Cheezwedge/CanCrusherSim/docs/platen-shapes-standard-subset.md

| Platen | Force to get the can to 25 / 20 / 15 / 12 mm thick (N) | Thinnest under load (mm) | Platen energy (J) | Thickness after release (mm) |
|---|---|---|---|---|
| Flat | 965 / 1,301 / 2,367 / 3,134 | 7.0 | 72 | 7.3 |
| Two side plates, 24 mm gap where the bar went | 949 / 1,298 / 2,544 / — | 13.7 | 70 | 13.7 |
| Two side plates, 40 mm gap where the bar went | — / — / — / — | 25.9 | 61 | 26.1 |
