Cheezwedge/CanCrusherSim/docs/one-stroke-coarse.md

| Design | Strokes | Peak press force to reach 25 / 20 / 15 / 12 mm (N) | Energy (J) | Final thickness (mm) |
|---|---|---|---|---|
| Two presses: Ø20 bar, retract, flat platen | 2 | 1,240 / 1,622 / 2,398 / 3,532 | 80 | 8.1 |
| One stroke: bar 30 mm below slotted platen, spring 300→450 N | 1 | 2,419 / 3,387 / 4,443 / 6,699 | 131 | 11.4 |
| One stroke: bar 45 mm below slotted platen, spring 300→450 N | 1 | 2,614 / 3,117 / 3,391 / — | 108 | 12.9 |
| One stroke: bar 45 mm below, spring 200→300 N | 1 | 2,754 / 3,562 / 5,386 / — | 113 | 13.9 |
