Cheezwedge/CanCrusherSim/docs/platen-shapes-coarse.md

| Platen | Force to get the can to 25 / 20 / 15 / 12 mm thick (N) | Thinnest under load (mm) | Platen energy (J) | Thickness after release (mm) |
|---|---|---|---|---|
| Flat | 1,240 / 1,622 / 2,398 / 3,532 | 7.7 | 73 | 8.1 |
| Curved, bulging down (R 400 mm) | 1,363 / 1,888 / 2,774 / 4,254 | 9.8 | 76 | 10.0 |
| Curved, bulging down (R 250 mm) | 1,528 / 2,419 / 2,996 / 5,923 | 10.6 | 83 | 10.9 |
| Curved, dished up (R 400 mm) | 1,103 / 1,737 / 2,757 / — | 14.0 | 47 | 14.2 |
| Roof / V pointing down (5°) | 1,383 / 2,602 / 3,359 / 5,451 | 10.2 | 83 | 10.5 |
| Valley / V pointing up (5°) | 1,141 / 1,952 / 3,113 / — | 12.0 | 58 | 12.4 |
| Flat, tilted 8° (one end first) | 2,067 / — / — / — | 22.1 | 40 | 22.9 |
| Hinged clamshell (pivot past one end) | 3,797 / 4,691 / 6,694 / 8,021 | 10.9 | 88 | 11.2 |
