Cheezwedge/CanCrusherSim/docs/two-stage-study-coarse-subset.md

| First press | Press 1 peak (N) | Pull-out on retract (N) | Metal on top of tool | Platen force to 20 / 15 / 10 mm (N) | Final height (mm) | Total energy (J) |
|---|---|---|---|---|---|---|
| Ø10 round bar across the middle | 187 | 1 | no | 1,901 / 2,440 / 5,908 | 8.8 | 88 |
| Ø30 round bar across the middle | 276 | 51 (stuck) | no | 1,791 / 2,952 / 5,062 | 8.2 | 81 |
| Ø20 round bar across the middle, stop at 20 mm | 184 | 0 | no | 2,328 / 2,803 / 5,957 | 8.4 | 98 |
