Cheezwedge/CanCrusherSim/docs/two-stage-study-coarse.md

| First press | Press 1 peak (N) | Pull-out on retract (N) | Metal on top of tool | Platen force to 20 / 15 / 10 mm (N) | Final height (mm) | Total energy (J) |
|---|---|---|---|---|---|---|
| Full flat plate (single press, reference) | 8,738 | — | — | 2,856 / 3,229 / 8,578 | 10.4 | 114 |
| 3 mm plate, 50 mm wide, across the middle, no rod | 464 | 1,406 (stuck) | yes | 1,743 / 2,780 / 5,432 | 8.5 | 76 |
| 20 mm plate, 50 mm wide, across the middle, no rod | 1,202 | 418 (stuck) | yes | 1,772 / 2,784 / 5,468 | 8.8 | 84 |
| 40 mm block, 50 mm wide, across the middle | 1,646 | 75 (stuck) | no | 1,017 / 2,210 / 4,931 | 8.5 | 81 |
| 40 mm block, 50 mm wide, across, stop at 20 mm | 775 | 12 | no | 1,100 / 2,277 / 5,072 | 8.5 | 64 |
| 20 mm wide × 30 mm tall blade across the middle | 258 | 6 | yes | 2,283 / 2,596 / 4,771 | 8.3 | 81 |
| Ø20 round bar across the middle | 226 | 4 | no | 1,636 / 2,398 / 4,422 | 8.1 | 80 |
| Ø40 round bar across the middle | 578 | 154 | yes | 1,352 / 2,165 / 4,546 | 8.4 | 64 |
| Ø20 round bar along the can | 3,979 | 140 | yes | 4,195 / 5,857 / 8,083 | 10.1 | 181 |
| 30 mm wide × 20 mm plate along the can | 6,256 | 49 | no | 1,896 / 3,277 / 7,187 | 9.3 | 169 |
| Top-down, can tilted 15°, full plate to 25 mm | 1,617 | 0 | no | 2,188 / 2,711 / 6,377 | 9.3 | 99 |
