Cheezwedge/CanCrusherSim/docs/two-stage-study-standard-subset.md

| First press | Press 1 peak (N) | Pull-out on retract (N) | Metal on top of tool | Platen force to 20 / 15 / 10 mm (N) | Final height (mm) | Total energy (J) |
|---|---|---|---|---|---|---|
| Full flat plate (single press, reference) | 8,495 | — | — | 2,441 / 3,595 / 5,715 | 9.1 | 119 |
| 3 mm plate, 50 mm wide, across the middle, no rod | 372 | 466 | yes | 897 / 1,688 / 4,516 | 6.5 | 65 |
| 40 mm block, 50 mm wide, across, stop at 20 mm | 748 | 7 | no | 796 / 1,747 / 4,280 | 6.5 | 68 |
| 20 mm wide × 30 mm tall blade across the middle | 224 | 2 | no | 1,515 / 2,319 / 4,075 | 7.2 | 78 |
| Ø20 round bar across the middle | 172 | 0 | no | 1,322 / 2,392 / 4,506 | 7.3 | 77 |
| Ø10 round bar across the middle | 150 | 0 | no | 1,245 / 2,697 / 4,509 | 7.6 | 82 |
