Cheezwedge/CanCrusherSim/cad/out/can_crusher_assembly_closed.step

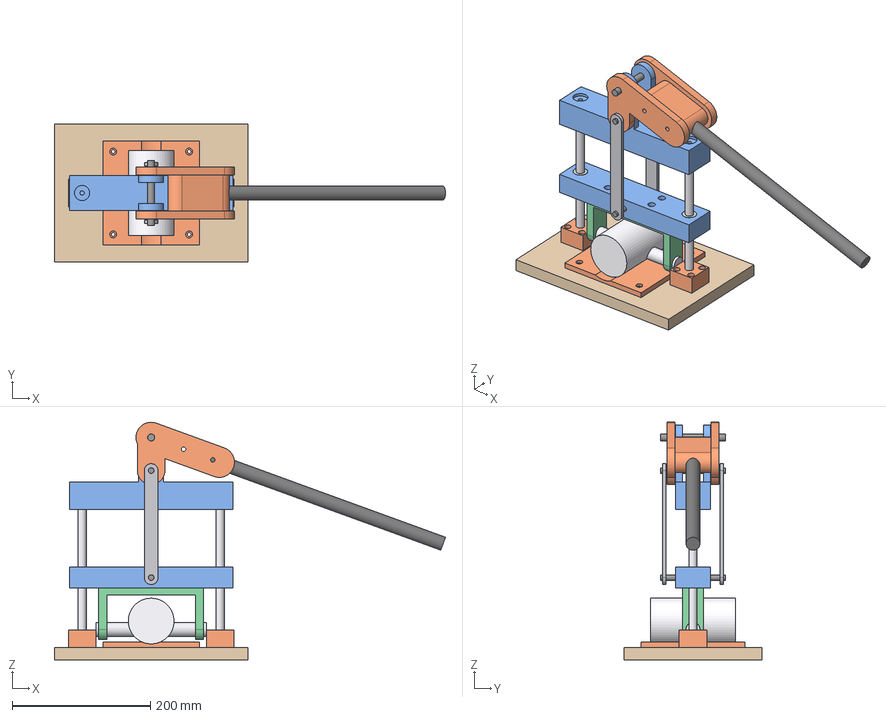
[picture p6: CAD file, 2026-11-07]
cad/out/can_crusher_assembly_closed.step
566.3 x 200.0 x 344.0 mm
base_plate
post_foot_L
post_foot_R
guide_post_L
guide_post_R
cradle
crosshead
bushing_L
bushing_R
bridge
crank_plate_F
crank_plate_B
handle_socket
handle
link_F
link_B
pins
bar_head
crease_bar
can
