Cheezwedge/CanCrusherSim/cad/out_progressive/progressive_crusher_assembly_open.step

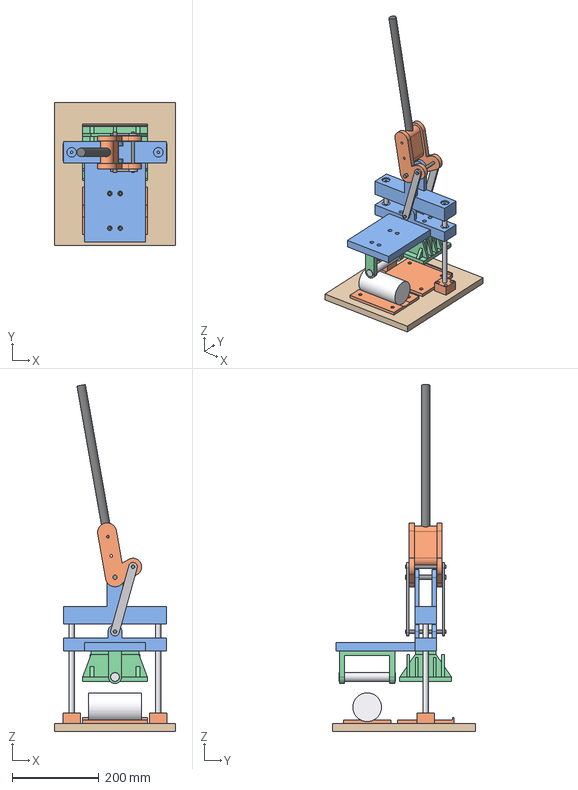
[picture p7: CAD file, 2026-11-07]
cad/out_progressive/progressive_crusher_assembly_open.step
280.0 x 330.0 x 800.9 mm
base_plate
post_foot_L
post_foot_R
guide_post_L
guide_post_R
cradle_station1
pad_station2
crosshead
bushing_L
bushing_R
bridge
crank_plate_F
crank_plate_B
handle_socket
handle
link_F
link_B
pins
bar_head
crease_bar
platen_head
can_station1
