Cheezwedge/CanCrusherSim/cad/out/step/cradle.step

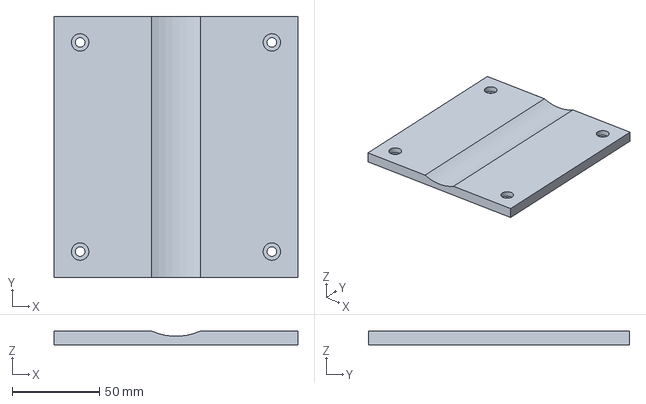
[picture p8: CAD file, 2026-11-07]
cad/out/step/cradle.step
140.0 x 150.0 x 8.00 mm
