Cheezwedge/CanCrusherSim/cad/out_progressive/dxf/link.dxf

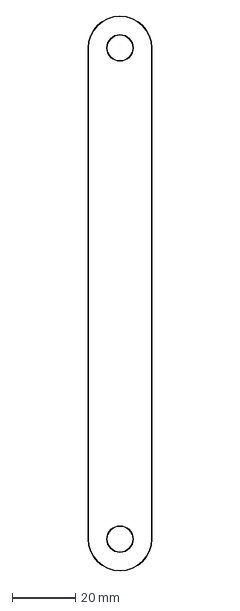
[picture p9: CAD file, 2026-11-07]
cad/out_progressive/dxf/link.dxf
20.0 x 175.0 mm
