Cheezwedge/CanCrusherSim/cad/out_progressive/step/pad_station2.step

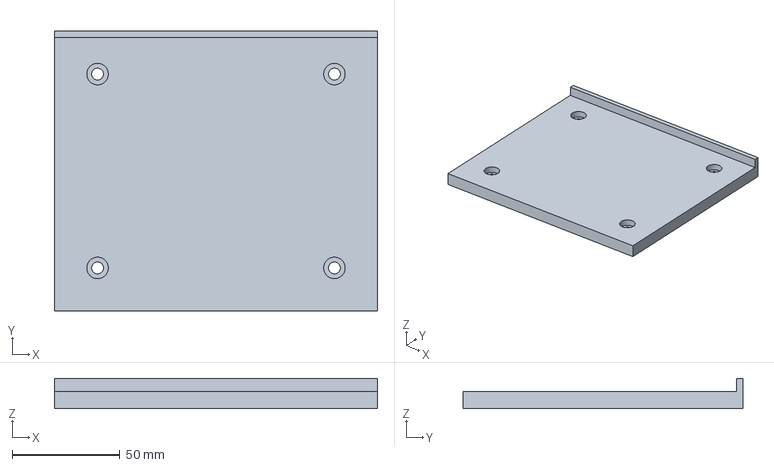
[picture p10: CAD file, 2026-11-07]
cad/out_progressive/step/pad_station2.step
150.0 x 130.0 x 14.0 mm
