Cheezwedge/CanCrusherSim/cad/out_progressive/stl/crank_plate.stl

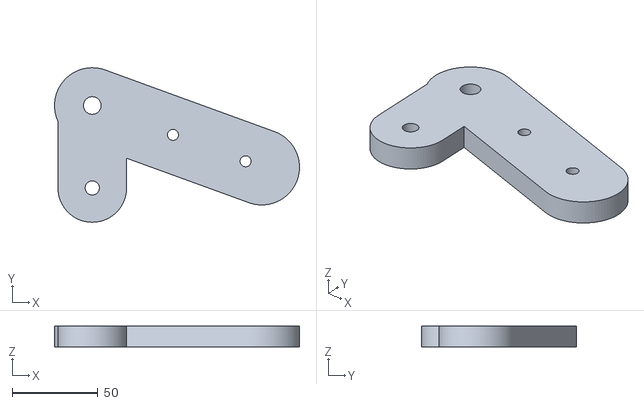
[picture p11: CAD file, 2026-11-07]
cad/out_progressive/stl/crank_plate.stl
142.7 x 90.0 x 12.0
