Cheezwedge/CanCrusherSim/cad/out_rotary/rotary_crusher_crease.step

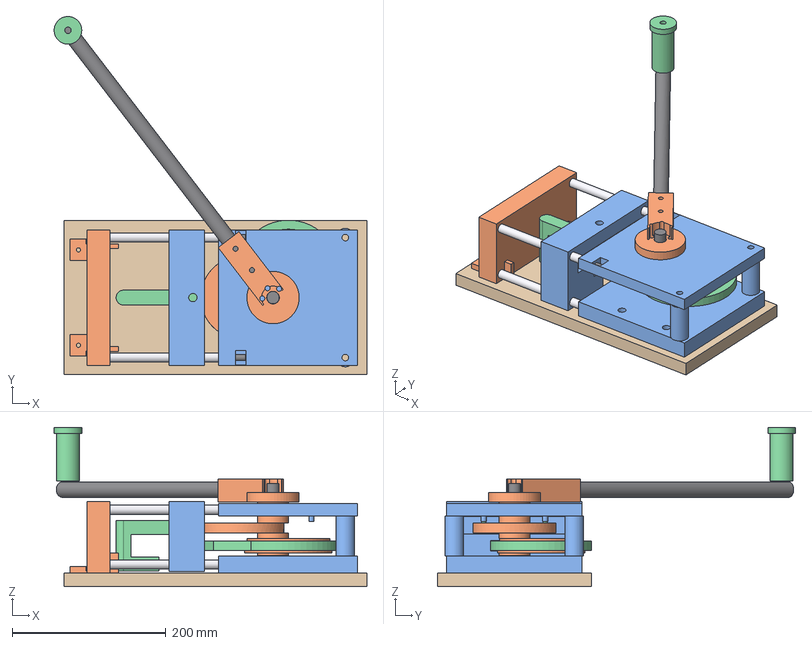
[picture p12: CAD file, 2026-11-11]
cad/out_rotary/rotary_crusher_crease.step
406.6 x 465.5 x 207.2 mm
board
fixed_jaw
platen
wrist_pin
blade
conrod
rotor_lower
rotor_upper
bottom_plate
top_plate
back_post_L
back_post_R
guide_tubes
tie_rods
axle
handle_hub
handle
knob
