Cheezwedge/CanCrusherSim/cad/out_rotary/step/platen.step

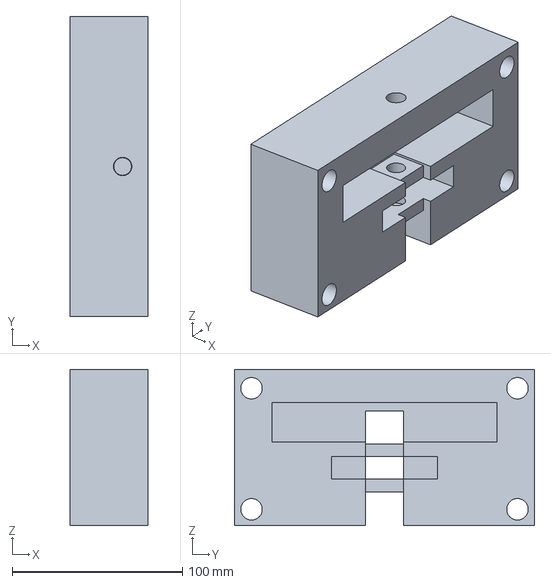
[picture p13: CAD file, 2026-11-11]
cad/out_rotary/step/platen.step
46.0 x 176.0 x 91.5 mm
