Cheezwedge/CanCrusherSim/cad/out_rotary/stl/back_post.stl

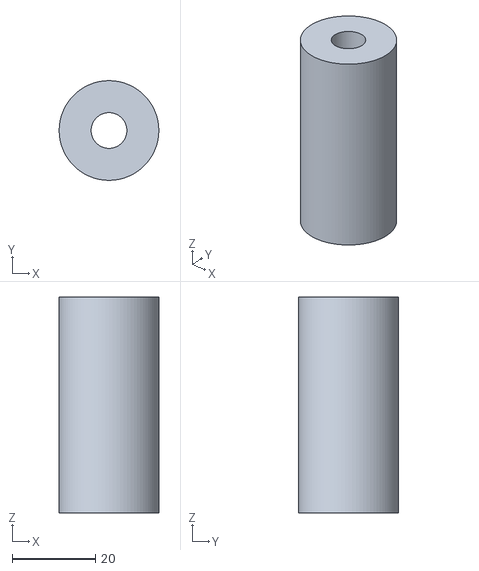
[picture p14: CAD file, 2026-11-11]
cad/out_rotary/stl/back_post.stl
24.0 x 24.0 x 52.0
