Cheezwedge/CanCrusherSim/cad/out_progressive/step/post_foot_R.step

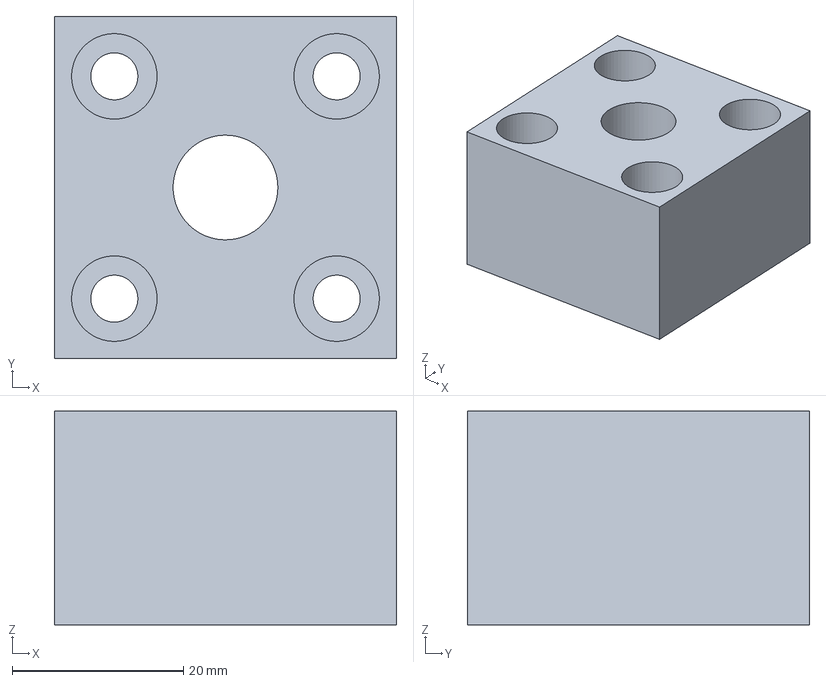
[picture p15: CAD file, 2026-11-07]
cad/out_progressive/step/post_foot_R.step
40.0 x 40.0 x 25.0 mm
