Cheezwedge/CanCrusherSim/cad/out_rotary/rotary_crusher_load.step

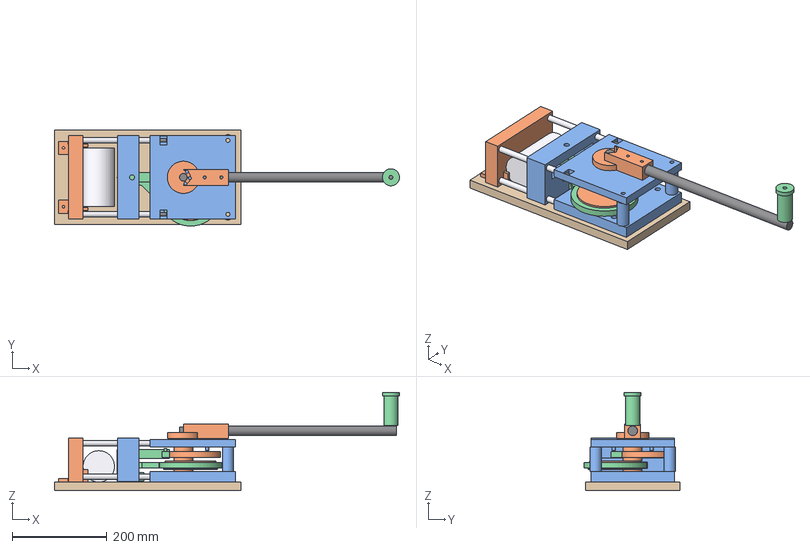
[picture p16: CAD file, 2026-11-11]
cad/out_rotary/rotary_crusher_load.step
728.0 x 202.9 x 207.2 mm
board
fixed_jaw
platen
wrist_pin
blade
conrod
rotor_lower
rotor_upper
bottom_plate
top_plate
back_post_L
back_post_R
guide_tubes
tie_rods
axle
handle_hub
handle
knob
can
