Cheezwedge/CanCrusherSim/cad/out_rotary/step/tie_rods.step

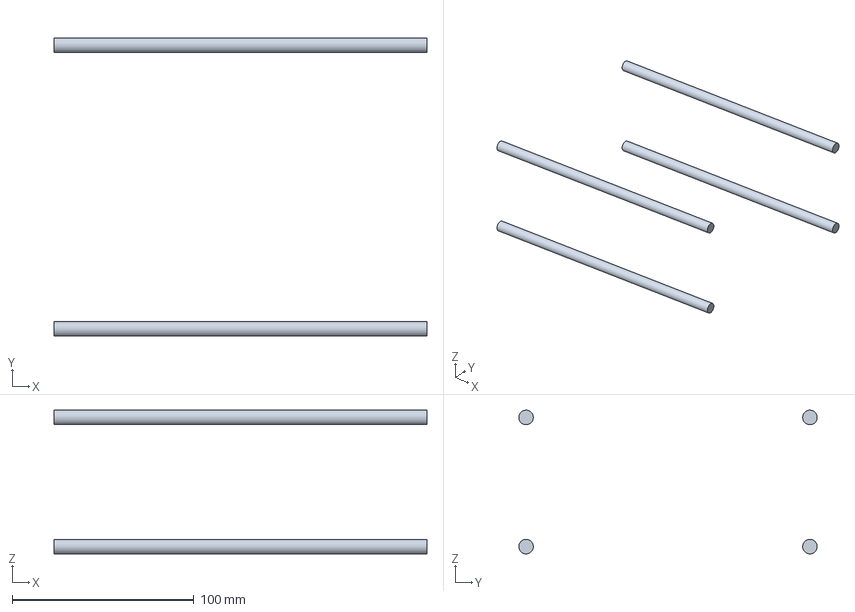
[picture p17: CAD file, 2026-11-11]
cad/out_rotary/step/tie_rods.step
205.0 x 164.0 x 79.0 mm
