Cheezwedge/CanCrusherSim/cad/out_progressive/step/guide_post_R.step

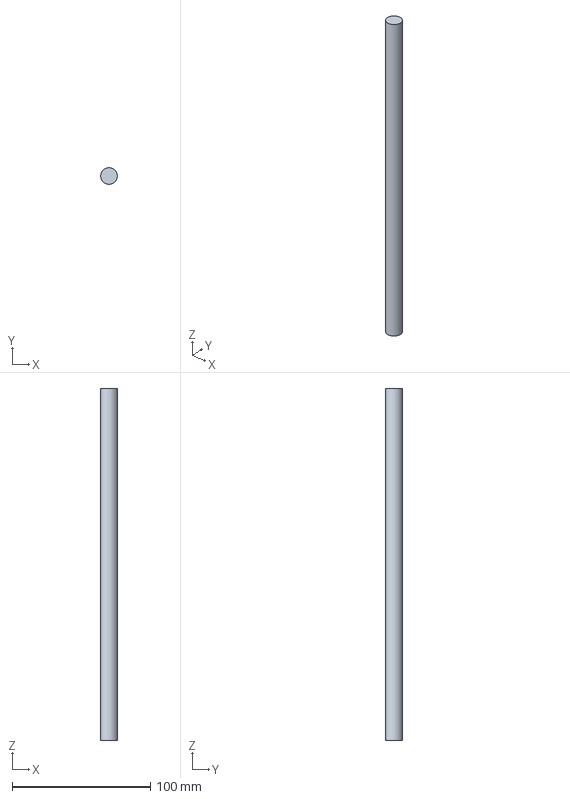
[picture p18: CAD file, 2026-11-07]
cad/out_progressive/step/guide_post_R.step
12.0 x 12.0 x 254.2 mm
