Cheezwedge/CanCrusherSim/cad/out_rotary/rotary_crusher_pressed.step

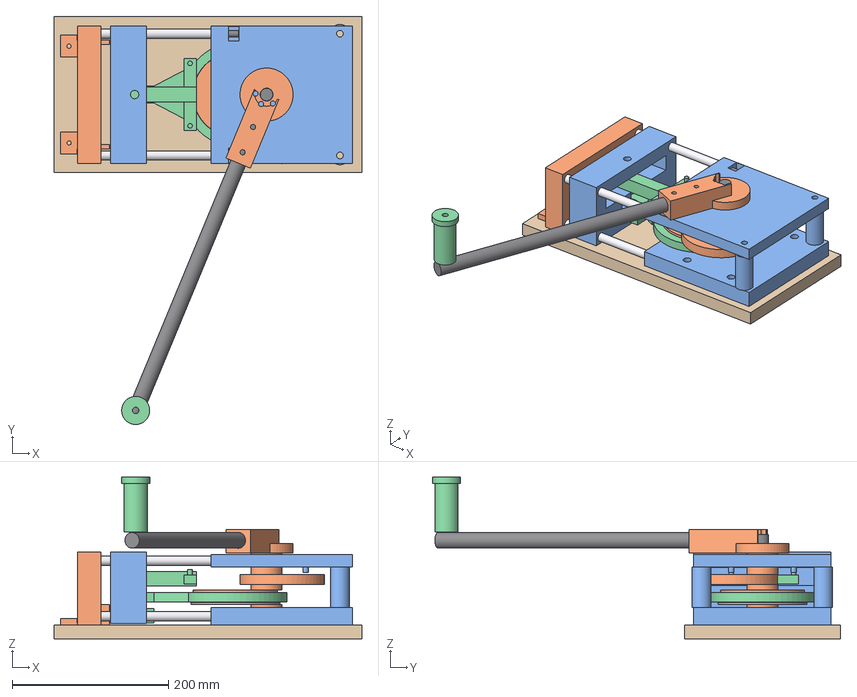
[picture p19: CAD file, 2026-11-11]
cad/out_rotary/rotary_crusher_pressed.step
394.0 x 522.7 x 207.2 mm
board
fixed_jaw
platen
wrist_pin
blade
conrod
rotor_lower
rotor_upper
bottom_plate
top_plate
back_post_L
back_post_R
guide_tubes
tie_rods
axle
handle_hub
handle
knob
