Cheezwedge/CanCrusherSim/cad/out_rotary/step/handle_hub.step

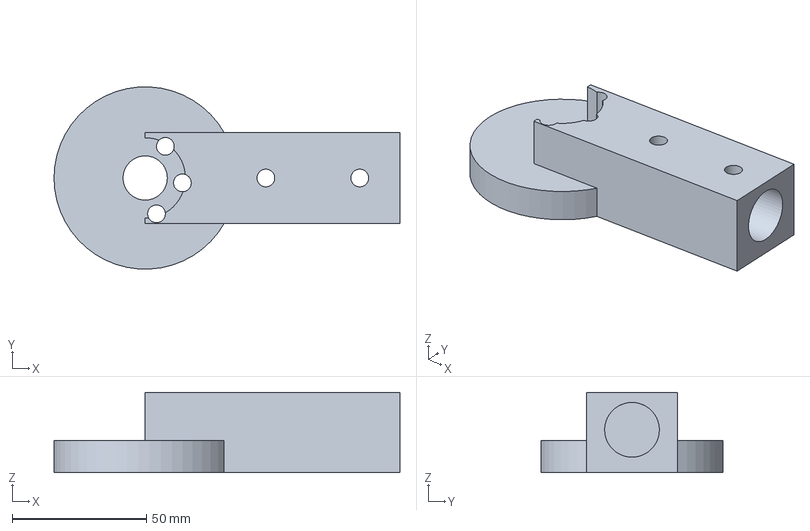
[picture p20: CAD file, 2026-11-11]
cad/out_rotary/step/handle_hub.step
129.0 x 67.9 x 30.0 mm
