Cheezwedge/CanCrusherSim/cad/out_progressive/step/bushing_R.step

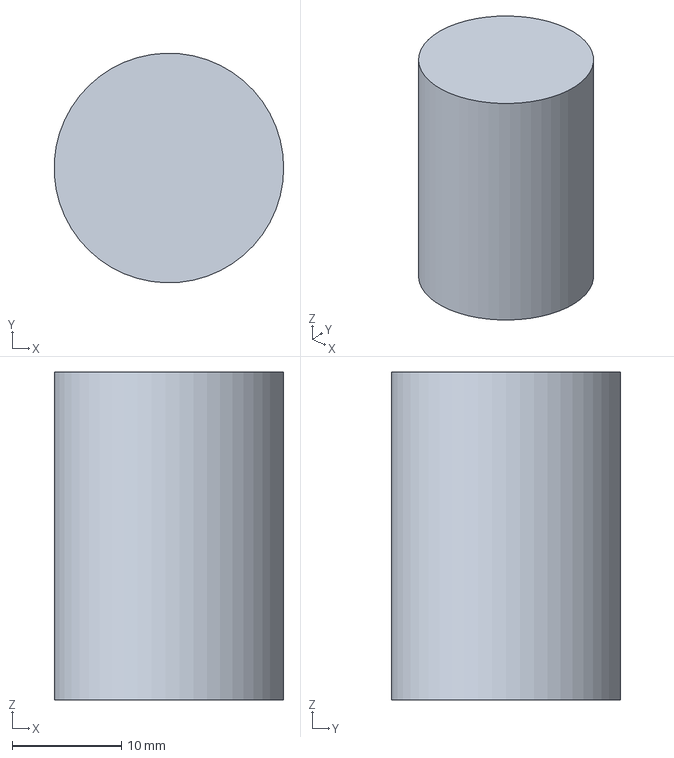
[picture p21: CAD file, 2026-11-07]
cad/out_progressive/step/bushing_R.step
21.0 x 21.0 x 30.0 mm
