Cheezwedge/CanCrusherSim/cad/out_rotary/step/handle.step

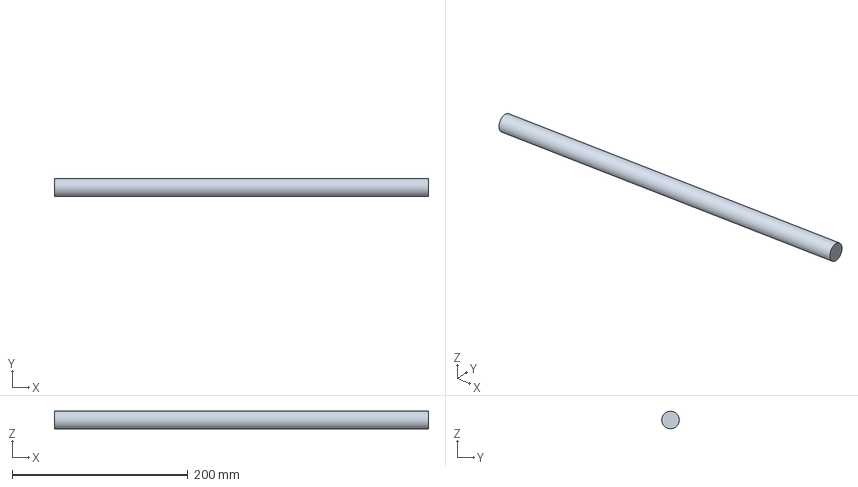
[picture p22: CAD file, 2026-11-11]
cad/out_rotary/step/handle.step
426.0 x 20.0 x 20.0 mm
