Cheezwedge/CanCrusherSim/cad/out_progressive/step/bar_head.step

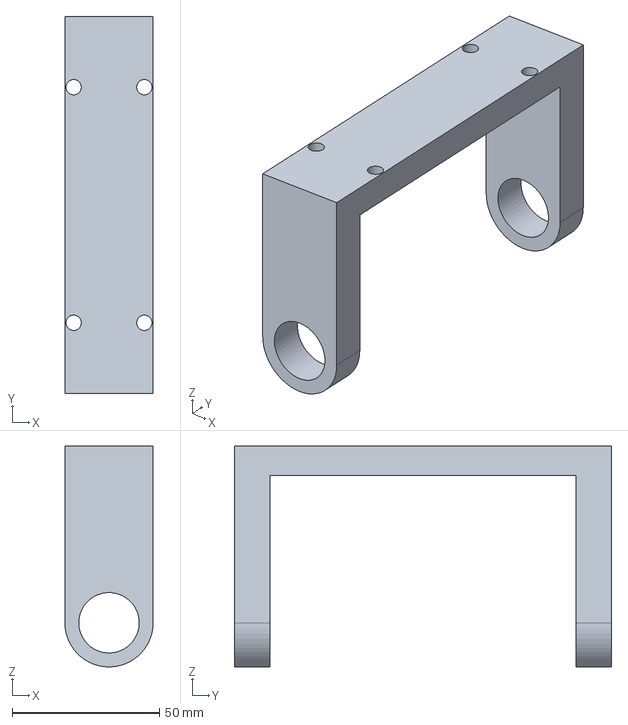
[picture p23: CAD file, 2026-11-07]
cad/out_progressive/step/bar_head.step
30.0 x 128.0 x 75.0 mm
