Cheezwedge/CanCrusherSim/cad/out_rotary/step/fixed_jaw.step

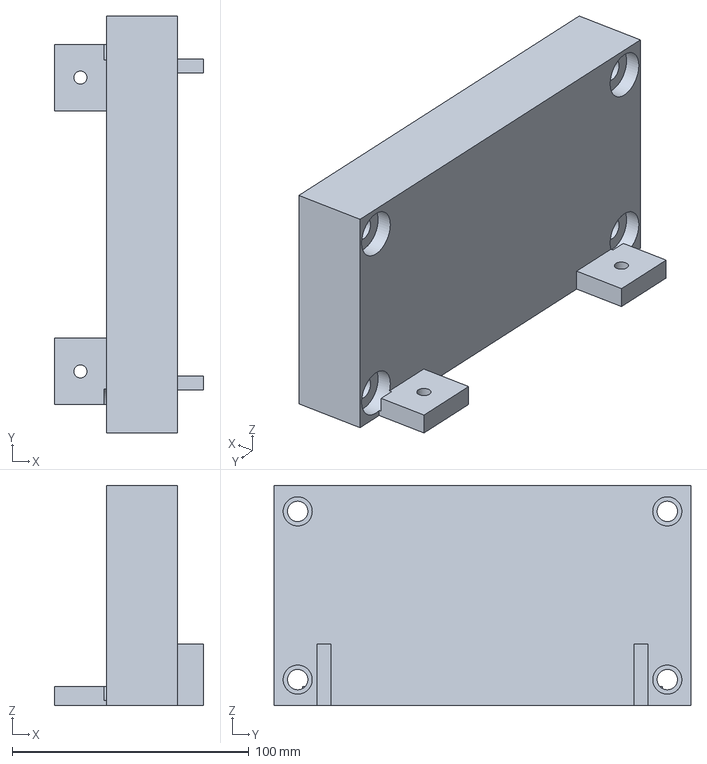
[picture p24: CAD file, 2026-11-11]
cad/out_rotary/step/fixed_jaw.step
63.0 x 176.0 x 93.0 mm
