Cheezwedge/CanCrusherSim/cad/out_rotary/step/bottom_plate.step

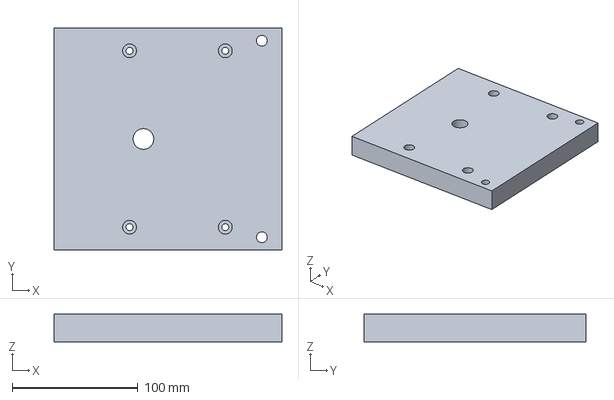
[picture p25: CAD file, 2026-11-11]
cad/out_rotary/step/bottom_plate.step
181.0 x 176.0 x 22.0 mm
