Cheezwedge/CanCrusherSim/cad/out_progressive/step/can_station1.step

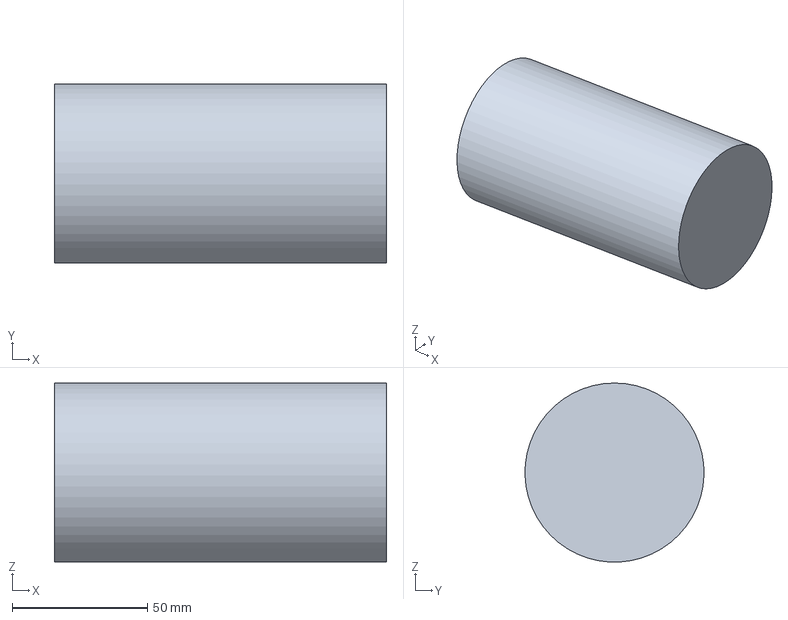
[picture p26: CAD file, 2026-11-07]
cad/out_progressive/step/can_station1.step
122.7 x 66.2 x 66.1 mm
