Cheezwedge/CanCrusherSim/cad/out_rotary/step/wrist_pin.step

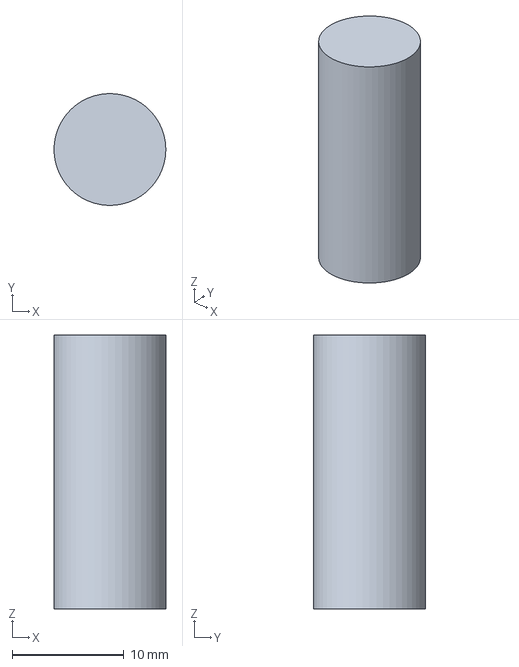
[picture p27: CAD file, 2026-11-11]
cad/out_rotary/step/wrist_pin.step
9.99 x 10.00 x 24.5 mm
