Cheezwedge/CanCrusherSim/cad/out_progressive/step/cradle_station1.step

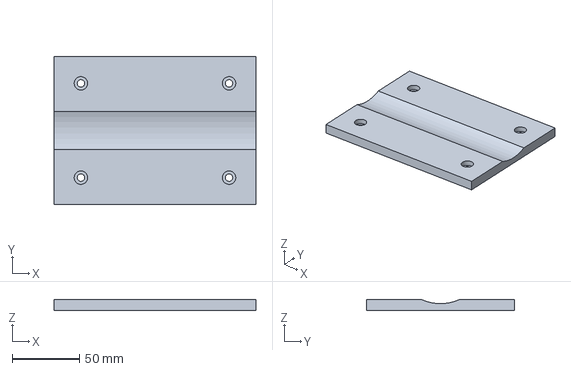
[picture p28: CAD file, 2026-11-07]
cad/out_progressive/step/cradle_station1.step
150.0 x 110.0 x 8.00 mm
