Cheezwedge/CanCrusherSim/cad/out_rotary/step/axle.step

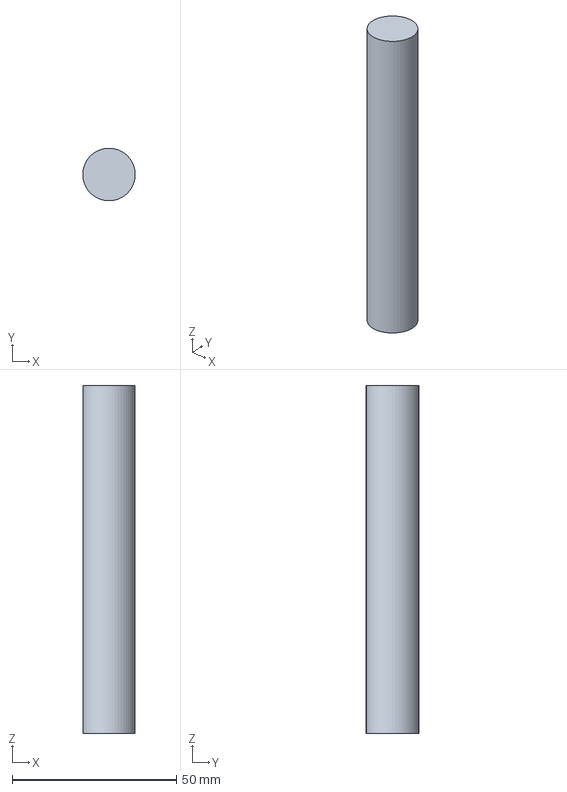
[picture p29: CAD file, 2026-11-11]
cad/out_rotary/step/axle.step
16.0 x 16.0 x 106.0 mm
