Cheezwedge/CanCrusherSim/cad/out_rotary/step/rotor_upper.step

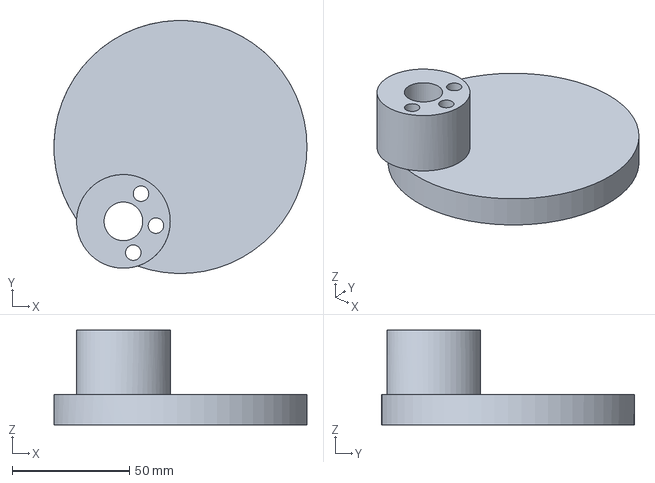
[picture p30: CAD file, 2026-11-11]
cad/out_rotary/step/rotor_upper.step
108.0 x 108.0 x 40.5 mm
