Cheezwedge/CanCrusherSim/cad/out_progressive/step/crosshead.step

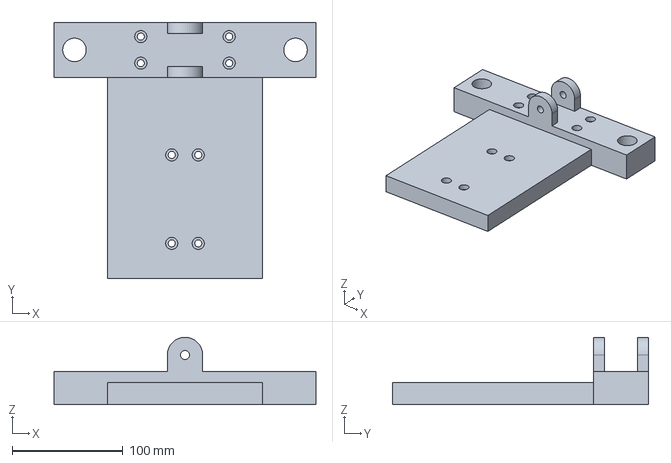
[picture p31: CAD file, 2026-11-07]
cad/out_progressive/step/crosshead.step
237.0 x 232.0 x 61.0 mm
