Cheezwedge/CanCrusherSim/cad/out_rotary/step/blade.step

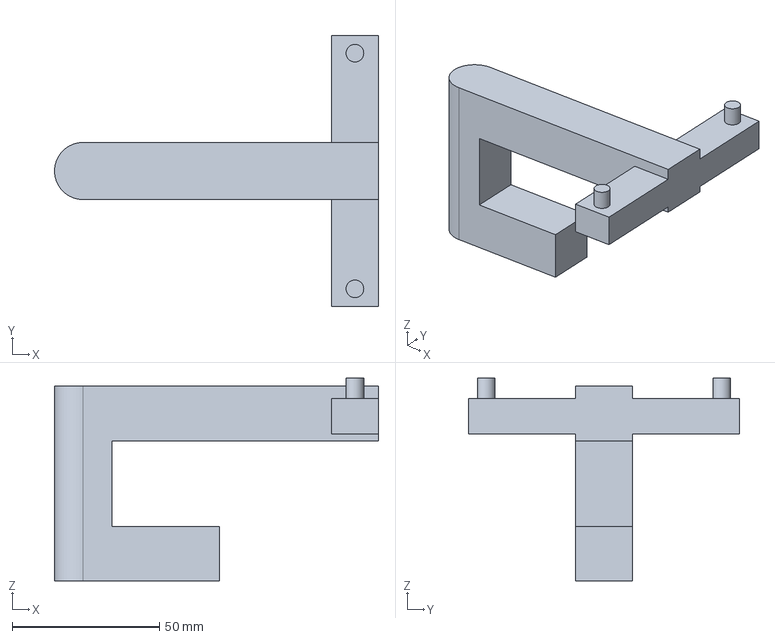
[picture p32: CAD file, 2026-11-11]
cad/out_rotary/step/blade.step
110.0 x 92.0 x 68.9 mm
