Cheezwedge/CanCrusherSim/cad/out_progressive/step/bridge.step

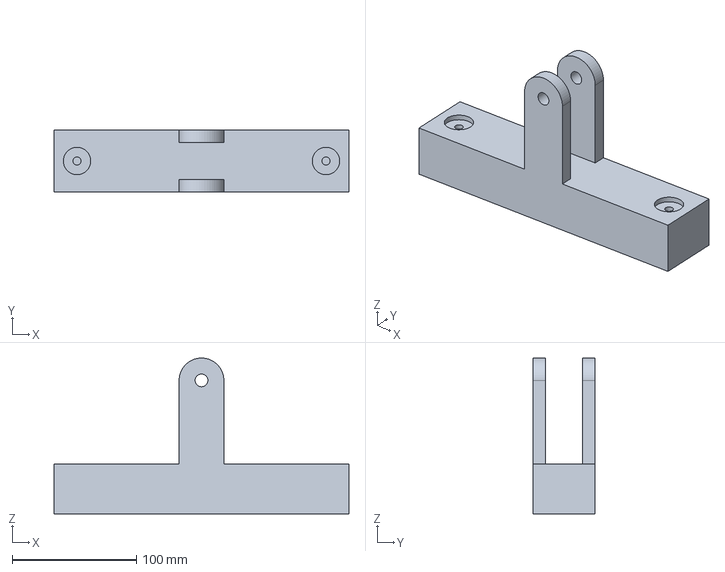
[picture p33: CAD file, 2026-11-07]
cad/out_progressive/step/bridge.step
237.0 x 50.0 x 125.3 mm
