Cheezwedge/CanCrusherSim/cad/out_rotary/step/guide_tubes.step

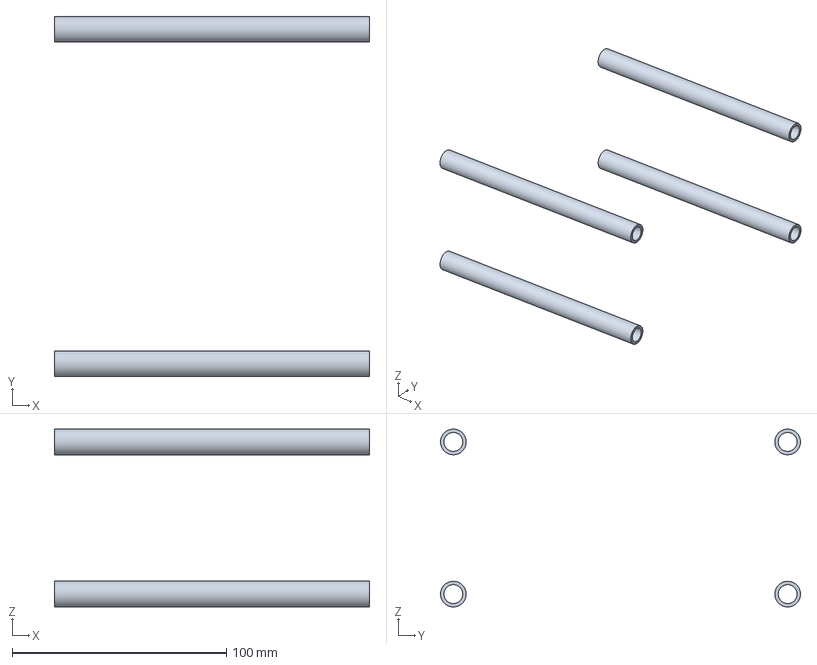
[picture p34: CAD file, 2026-11-11]
cad/out_rotary/step/guide_tubes.step
147.0 x 168.0 x 83.0 mm
