Cheezwedge/CanCrusherSim/cad/out_progressive/step/handle.step

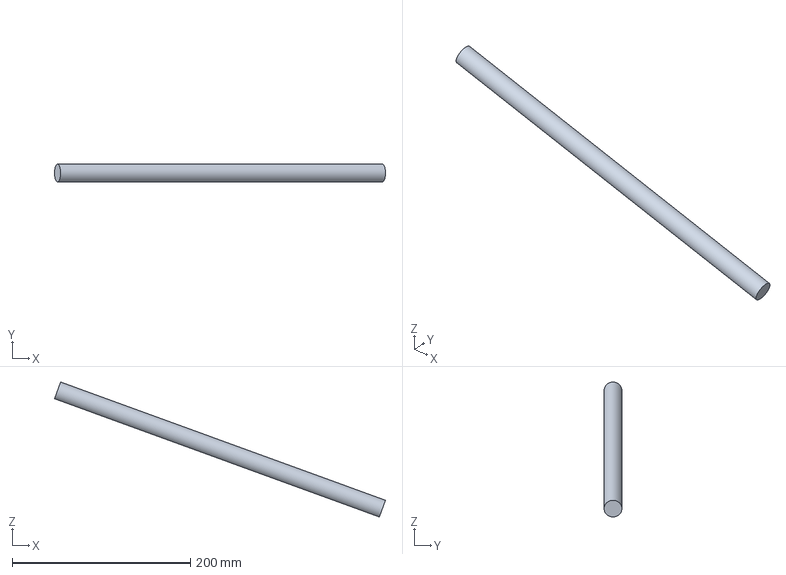
[picture p35: CAD file, 2026-11-07]
cad/out_progressive/step/handle.step
371.4 x 20.0 x 151.5 mm
