Cheezwedge/CanCrusherSim/cad/out_rotary/step/top_plate.step

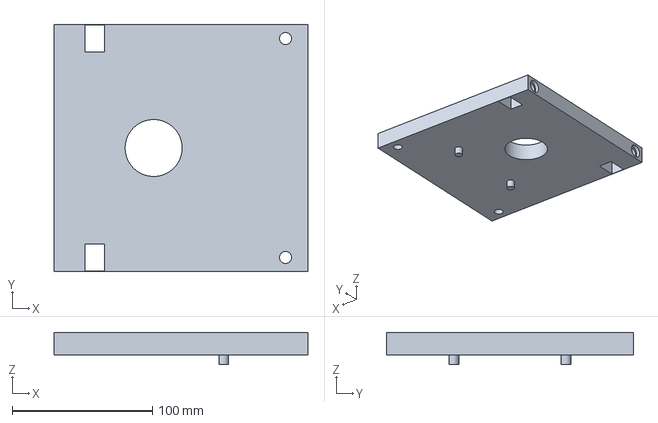
[picture p36: CAD file, 2026-11-11]
cad/out_rotary/step/top_plate.step
181.0 x 176.0 x 23.0 mm
