Cheezwedge/CanCrusherSim/cad/out_progressive/step/base_plate.step

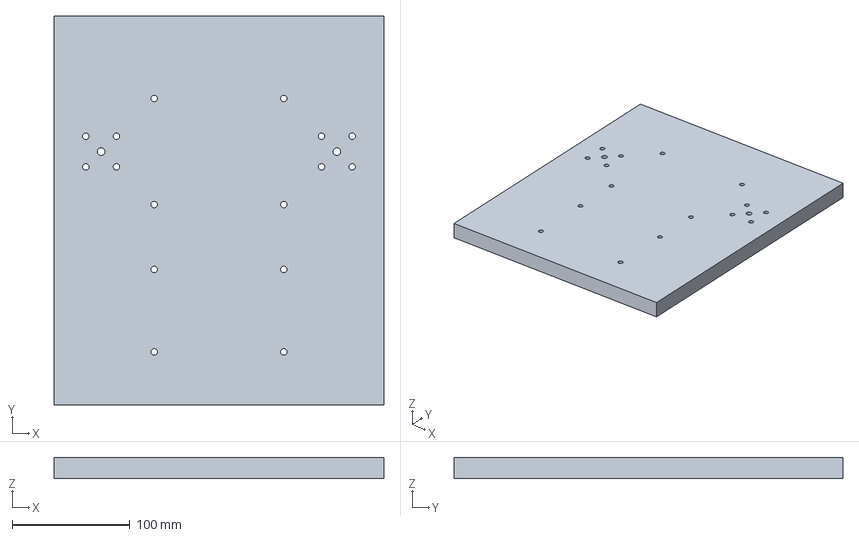
[picture p37: CAD file, 2026-11-07]
cad/out_progressive/step/base_plate.step
280.0 x 330.0 x 18.0 mm
