Cheezwedge/CanCrusherSim/cad/out_rotary/step/rotor_lower.step

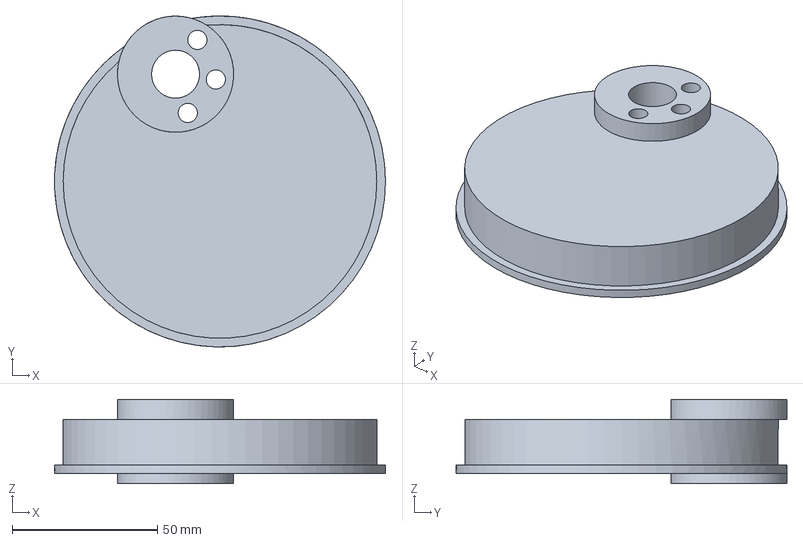
[picture p38: CAD file, 2026-11-11]
cad/out_rotary/step/rotor_lower.step
114.0 x 114.0 x 29.0 mm
