Cheezwedge/CanCrusherSim/cad/out_progressive/step/link_F.step

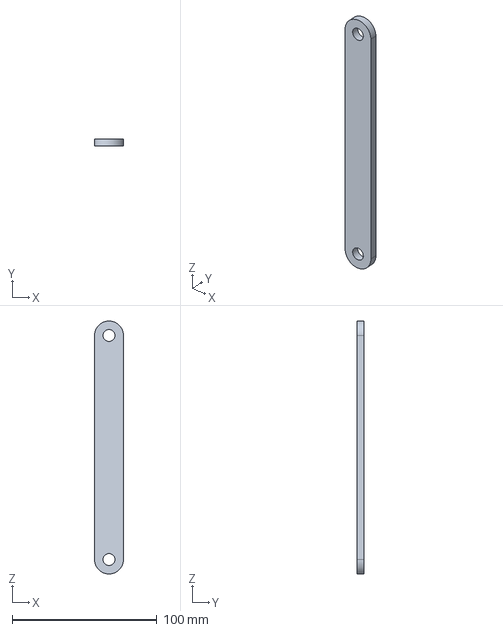
[picture p39: CAD file, 2026-11-07]
cad/out_progressive/step/link_F.step
20.0 x 5.00 x 175.0 mm
