Cheezwedge/CanCrusherSim/cad/out_rotary/step/board.step

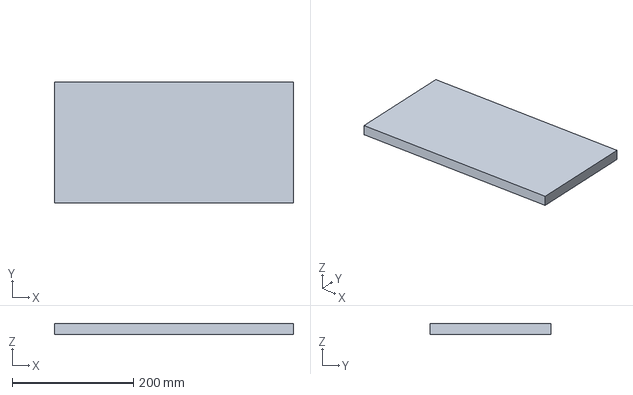
[picture p40: CAD file, 2026-11-11]
cad/out_rotary/step/board.step
394.0 x 200.0 x 18.0 mm
