Cheezwedge/CanCrusherSim/cad/out_progressive/step/handle_socket.step

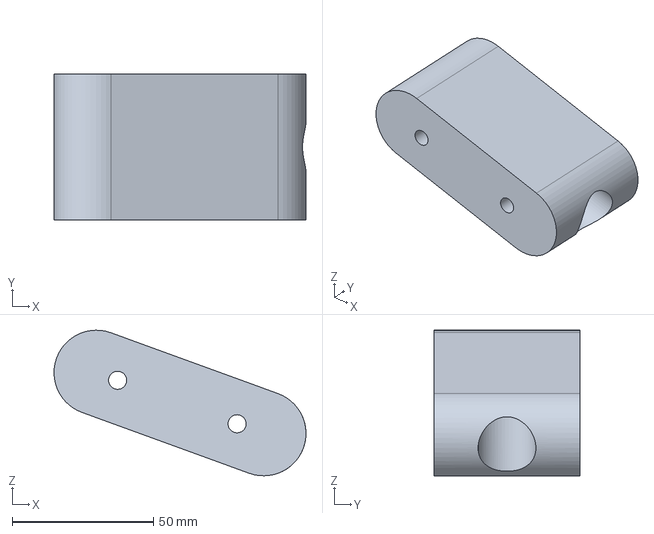
[picture p41: CAD file, 2026-11-07]
cad/out_progressive/step/handle_socket.step
89.2 x 51.6 x 51.5 mm
