Cheezwedge/CanCrusherSim/cad/out_rotary/step/conrod.step

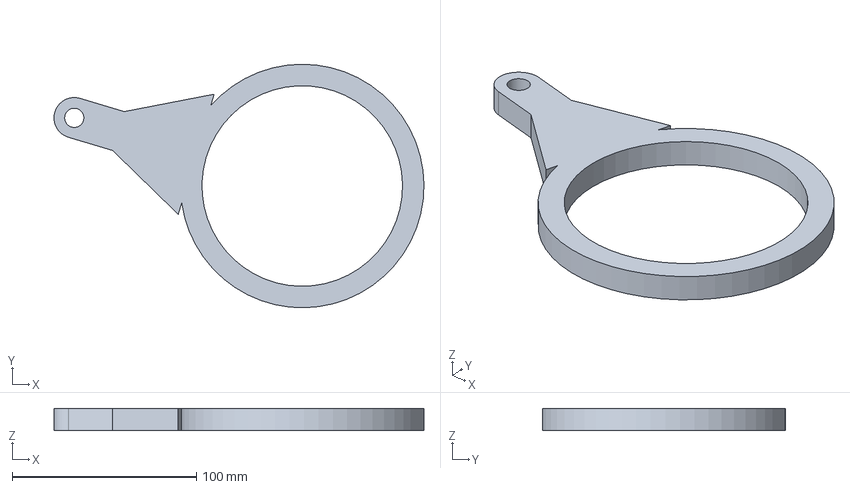
[picture p42: CAD file, 2026-11-11]
cad/out_rotary/step/conrod.step
200.6 x 132.0 x 12.0 mm
