Cheezwedge/CanCrusherSim/cad/out_progressive/step/pins.step

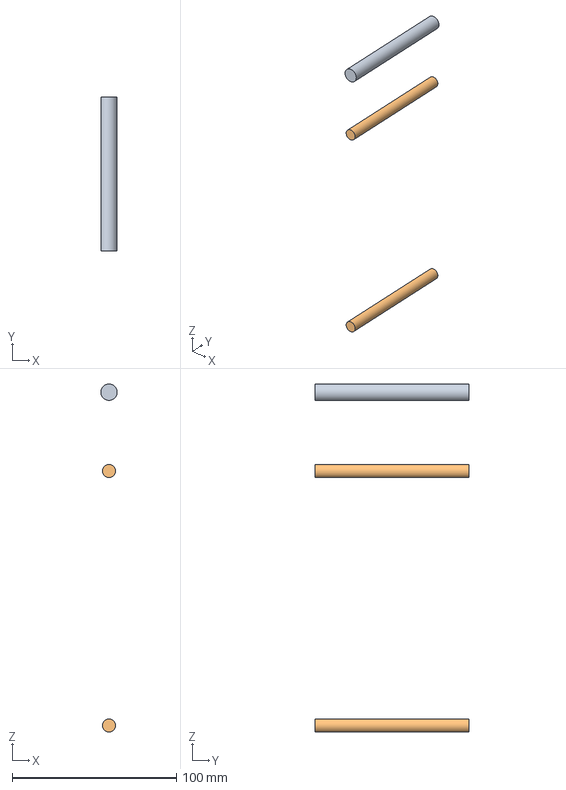
[picture p43: CAD file, 2026-11-07]
cad/out_progressive/step/pins.step
10.00 x 94.0 x 212.0 mm
