Cheezwedge/CanCrusherSim/cad/out_progressive/step/platen_head.step

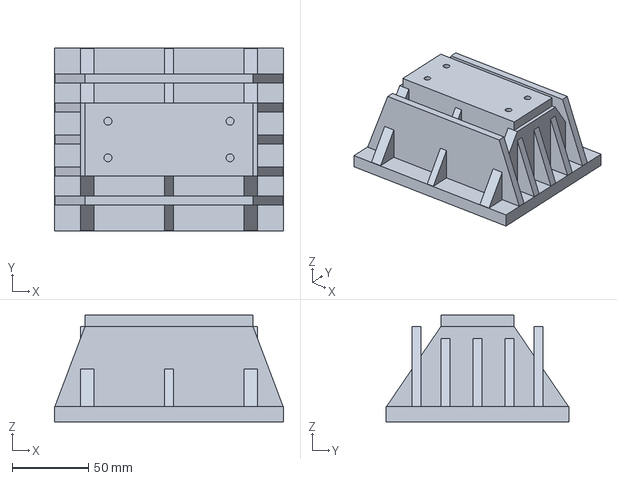
[picture p44: CAD file, 2026-11-07]
cad/out_progressive/step/platen_head.step
150.0 x 120.0 x 70.0 mm
