Cheezwedge/CanCrusherSim/cad/out_rotary/step/knob.step

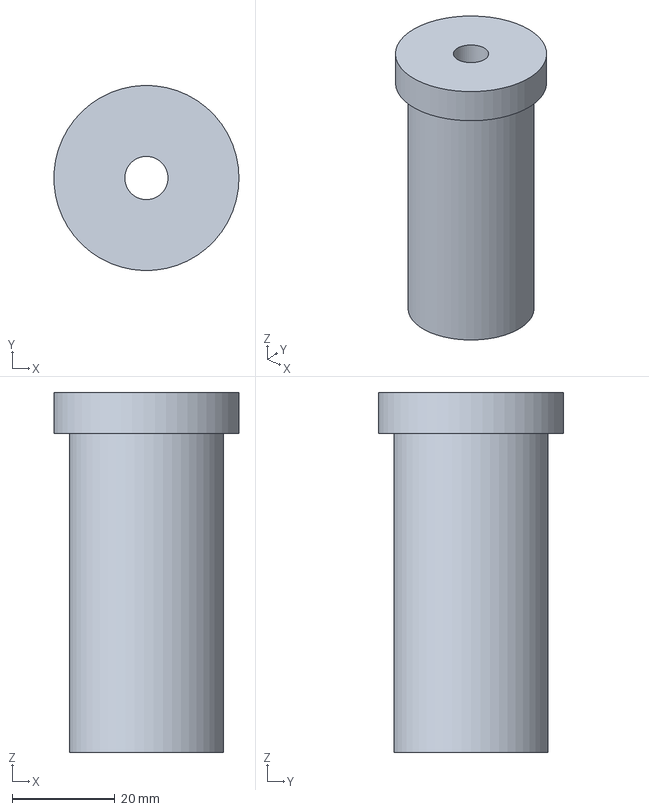
[picture p45: CAD file, 2026-11-11]
cad/out_rotary/step/knob.step
36.0 x 36.0 x 70.0 mm
