Cheezwedge/CanCrusherSim/cad/out_progressive/step/crease_bar.step

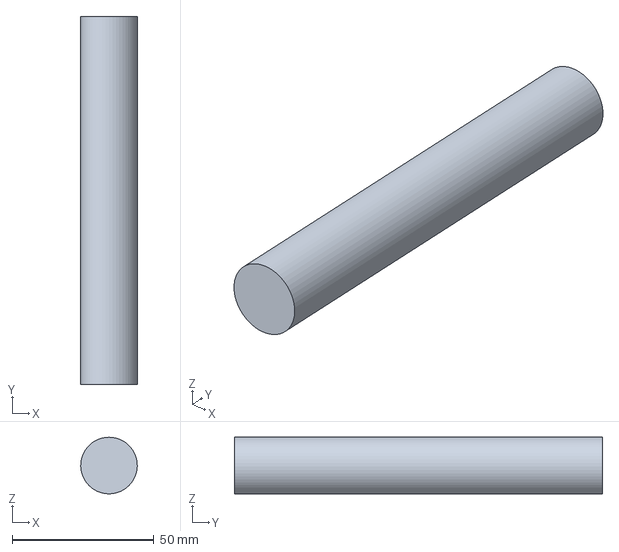
[picture p46: CAD file, 2026-11-07]
cad/out_progressive/step/crease_bar.step
20.0 x 130.0 x 20.0 mm
