Cheezwedge/CanCrusherSim/(list of files, cad)

Other CAD files:
cad/out_progressive/stl/post_foot.stl
cad/out_progressive/step/guide_post_L.step
cad/out_progressive/step/crank_plate_B.step
cad/out_rotary/step/back_post_R.step
cad/out/step/can.step
cad/out_progressive/step/crank_plate_F.step
cad/out_rotary/step/back_post_L.step
cad/out_progressive/step/link_B.step
cad/out_progressive/step/post_foot_L.step
cad/out_progressive/step/bushing_L.step
cad/out/dxf/base_plate.dxf
cad/out/dxf/link.dxf
cad/out/step/bar_head.step
cad/out/step/base_plate.step
cad/out/step/bridge.step
cad/out/step/bushing_L.step
cad/out/step/bushing_R.step
cad/out/step/crank_plate_B.step
cad/out/step/crank_plate_F.step
cad/out/step/crease_bar.step
cad/out/step/crosshead.step
cad/out/step/guide_post_L.step
cad/out/step/guide_post_R.step
cad/out/step/handle.step
cad/out/step/handle_socket.step
cad/out/step/link_B.step
cad/out/step/link_F.step
cad/out/step/pins.step
cad/out/step/platen_head.step
cad/out/step/post_foot_L.step
cad/out/step/post_foot_R.step
cad/out/stl/bar_head.stl
cad/out/stl/bridge.stl
cad/out/stl/cradle.stl
cad/out/stl/crank_plate.stl
cad/out/stl/crosshead.stl
cad/out/stl/handle_socket.stl
cad/out/stl/platen_head.stl
cad/out_progressive/dxf/base_plate.dxf
cad/out_progressive/stl/bar_head.stl
cad/out_progressive/stl/bridge.stl
cad/out_progressive/stl/cradle_station1.stl
cad/out_progressive/stl/crosshead.stl
cad/out_progressive/stl/handle_socket.stl
cad/out_progressive/stl/pad_station2.stl
cad/out_progressive/stl/platen_head.stl
cad/out_rotary/stl/blade.stl
cad/out_rotary/stl/bottom_plate.stl
cad/out_rotary/stl/conrod.stl
cad/out_rotary/stl/fixed_jaw.stl
cad/out_rotary/stl/handle_hub.stl
cad/out_rotary/stl/knob.stl
cad/out_rotary/stl/platen.stl
cad/out_rotary/stl/rotor_lower.stl
cad/out_rotary/stl/rotor_upper.stl
cad/out_rotary/stl/top_plate.stl
