Cheezwedge/CanCrusherSim/(commit log)

2026-11-07 Add 3D elastic-plastic can crushing simulator
    Browser app (Three.js) plus a JavaScript explicit-dynamics shell solver
    for crushing an aluminum beverage can top-down, from the side or at any
    angle, with a flat plate, round bar or round punch of any size.
    Physics: realistic can geometry and wall gauges, AA3104/5182 materials
    with Voce hardening, CST membrane with plane-stress J2 plasticity,
    rotation-free bending with an exact per-triangle curvature operator and
    plastic moment / N-M interaction, rigid tools with friction, shell
    self-contact, pressed pre-dents, mass scaling with a quasi-static speed
    governor. Validated against ring crush, plate bending and cylinder
    buckling theory (tests + npm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
2026-11-07 Add adjustable crusher thickness, solid press rod and fold-over contact
    - Plate thickness (2-40 mm) and punch height (3-40 mm) are now settings.
    Metal that rises past the edges of a thin crusher can fold over its top.
    - The press rod above the crusher is part of the rigid tool (Ø10/18/30 mm)
    or can be removed (crusher driven from its ends), so folded metal lands
    on it instead of passing through.
    - Tool contact is also checked at edge midpoints and triangle centres so
    thin plate edges and rods cannot slip between mesh nodes.
    - README: controls and the thin-vs-thick plate finding.
    Claude-Session: https://claude.ai/code/session_0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
2026-11-07 Add two-press sequence (crease, held retract, platen) and design study
    - Scenarios can run several presses in a row. Between presses the crusher
    retracts while the can is held on the bed; the pull-out force and
    whether metal is folded over the tool show if the mechanism snags.
    - Optional second press: a 160 mm flat platen flattens what press 1 left.
    - UI: "Then flatten with a second press" option, stage-aware status and
    tool display, pull-out and platen tiles, compare-table details.
    - tools/study-two-stage.mjs runs first-press candidates through the full
    sequence; results and conclusions in docs/two-stage-study.md.
    - Fix: bar crusher now reports its press-rod setting to the 3D view.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
2026-11-07 Add shaped and hinged second-press platens and platen-shape study
    - New rigid tools: profiled platen (convex/concave curve, roof/valley V,
    tilt) and a hinged clamshell platen that rotates about a pivot; contact
    now supports rotating tools (point velocity, resisting moment).
    - Second press can use any of these shapes (UI selector, 3D rendering,
    animated hinge).
    - History records the can's thickest point so platens are compared on
    the thickness they actually achieve.
    - tools/study-platen-shapes.mjs and docs/platen-shapes.md: flat wins.
    Claude-Session: https://claude.ai/code/session_015mGF5U7Fov2MResJnnkSFb
2026-11-07 Add parametric CAD model of a two-stage lever can crusher
    cad/can_crusher.py (CadQuery) builds a guided crosshead press with a
    crank-and-link lever, a Ø20 crease-bar head and a flat ribbed platen head,
    sized from the simulation results. Exports STEP assemblies (open/closed)
    and parts, print-oriented STLs, DXF profiles for the base and steel links,
    a SolidWorks global-variables file, BOM and a hand-force table.
    Interference-checked through the stroke; README covers SolidWorks import,
    printing, assembly and strength estimates.
    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
    [bar_head.step, bar_head.stl, base_plate.dxf, base_plate.step, bom.csv, bridge.step, bridge.stl, bushing_L.step]
2026-11-07 Add two-station (progressive) crusher and one-stroke head study
    - Simulator: spring-loaded crease bar inside a slotted platen (combo
    head). tools/study-one-stroke.mjs shows it needs ~2x the force because
    the folded halves get trapped beside the bar, so the bar must clear
    before flattening.
    - tools/progressive-forces.mjs: per-stroke force of a two-station press
    (bar on a fresh can + platen on a creased can).
    - cad/progressive_crusher.py: both tools on one crosshead, crease station
    in front of the flatten station; pin ears lift the links clear of the
    front arm; two-station cradles; STEP/STL/DXF/SolidWorks variables in
    cad/out_progressive. Interference-checked through the stroke;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
    [bar_head.step, bar_head.stl, base_plate.dxf, base_plate.step, bom_changes.csv, bridge.step, bridge.stl, bushing_L.step]
2026-11-08 Study a slotted (two side plate) second platen
    PlateTool gets an optional slot that splits it into two side plates;
    the second press can use it. Standard-mesh result: a 24 mm gap matches
    the flat platen down to 20 mm but stops at ~14 mm thick (the crease
    pushes up into the gap); 40 mm stops at ~26 mm. Documented in
    docs/two-step-mechanism.md.
    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
2026-11-11 Add low-profile rotary crusher: one crank turn creases then flattens
    - Simulator: kinematically driven double-action head (crease bar plus
    slotted platen following one crank), reporting crank torque.
    - tools/study-rotary.mjs: timing study. A 120 degree cam lead with a
    flush stop gives 47 N·m peak and a 15.5 mm can; 105 degrees traps the
    folded halves and doubles the torque.
    - tools/study-rib-platen.mjs: a fixed rib on the platen does not help.
    - cad/rotary_crusher.py: parametric model (cam + eccentric rotor, blade
    through the platen, tie-rod frame), with STEP assemblies, print-ready
    STLs, SolidWorks variables, BOM, collision checker and preview.
    - cad/ROTARY.md: how it works, resu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
    [axle.step, back_post.stl, back_post_L.step, back_post_R.step, blade.step, blade.stl, board.step, bom.csv]
